Freed-Wu/digital-clock-report/README.md

digital-clock-report
====================

A backup of my homework.

Dependent
---------

1.  A LaTex distribution. Such as [texlive].

Install
-------

``` {.zsh}
git clone git@github.com:Freed-Wu/digital-clock-report
cd digital-clock-report
latexmk -pvc main.tex
```

Q & A
-----

More question see [Issues].

If you don't wanna compile, you can download the complied paper from
[Release]

  [texlive]: https://github.com/TeX-Live/texlive-source
  [Issues]: https://github.com/Freed-Wu/digital-clock-report/issues
  [Release]: https://github.com/Freed-Wu/digital-clock-report/releases/
