Freed-Wu/digital-clock-report/src/clock.tex

\RequirePackage[l2tabu, orthodox]{nag}
\RequirePackage{ifxetex}
\RequireXeTeX

\documentclass[tikz]{standalone}

%颜色
\usepackage{xcolor}

%长度
\usepackage{printlen}
\uselengthunit{mm}

%图形
\usepackage{pifont}
\usepackage{ean13isbn}
\usepackage{qrcode}
\usepackage{pdfpages}
\usepackage{overpic}
\usepackage{graphicx}

\usepackage{pstricks}

\usepackage{pgfplots}
\pgfplotsset{compat=1.16}
\usepackage{pgfmath}
\usepackage{pgf-pie}
\usetikzlibrary{calc}
\usetikzlibrary{shapes.geometric}
\usetikzlibrary{patterns}
\usetikzlibrary{arrows}
\usetikzlibrary{shapes}
\usetikzlibrary{chains}
\usetikzlibrary{mindmap}
\usetikzlibrary{graphs}
\usetikzlibrary{decorations.text}
\usetikzlibrary{arrows.meta}
\usetikzlibrary{shadows.blur}
\usetikzlibrary{shadings}

\usepackage{scsnowman}
\usepackage{circuitikz}
\usepackage{tikzpeople}
\usepackage{tikzducks}
\usepackage{flowchart}
\usepackage{smartdiagram}
\usepackage[edges]{forest}

%公式
\usepackage{amsmath}
\usepackage{amsthm}
\usepackage{amsfonts}
\usepackage{amssymb}
\usepackage{amsbsy}
\usepackage{amsopn}
\usepackage{amstext}
\usepackage{mathrsfs}
\usepackage{bm}
\usepackage{textcomp}
\usepackage{latexsym}
\usepackage{exscale}
\usepackage{relsize}
%\usepackage{xymtex}
\usepackage{physics}
\usepackage{siunitx}
\usepackage{hologo}
\usepackage{cases}

%文字
\usepackage{csquotes}
\usepackage{microtype}
\usepackage{ctex}

\csname
endofdump
\endcsname

\begin{document}

\begin{tikzpicture}[scale=1, transform shape]
	\tikzset{node distance=1.5cm}
	\node[anchor=south west,inner sep=0] (image) at (0,0) {};
	\begin{scope}[x={(image.south east)},y={(image.north west)}]

		%\draw[help lines,xstep=.1,ystep=.1] (0,0) grid (1,1);
		%\foreach \x in {0,1,...,9} {
		%\node [anchor=north] at (\x/10,0) {0.\x};
		%}
		%\foreach \y in {0,1,...,9} {
		%\node [anchor=east] at (0,\y/10) {0.\y};
		%}

		\draw[red, rounded corners] (0.05,0.85) rectangle (0.12,0.95);
		\node(电源总开关) at (0.09,0.95) [red, align=center, anchor=south] {\tiny 电源总开关};
		\draw[red, rounded corners] (.2,.75) rectangle (.55,.95);
		\node(动态译码) at (.35,.95) [red, align=center, anchor=south] {\tiny 动态译码};
		\draw[red, rounded corners] (.56,.82) rectangle (.8,.95);
		\node(显示) at (.65,.95) [red, align=center, anchor=south] {\tiny 显示};
		\draw[red, rounded corners] (.6,.62) rectangle (.83,.75);
		\node(亮度调节) at (.73,.75) [red, align=center, anchor=south] {\tiny 亮度调节};
		\draw[red, rounded corners] (.1,.45) rectangle (.44,.6);
		\node(计数) at (.35,.6) [red, align=center, anchor=south] {\tiny 计数};
		\draw[red, rounded corners] (.46,.45) rectangle (.85,.6);
		\node(动态选通) at (.55,.6) [red, align=center, anchor=south] {\tiny 动态选通};
		\draw[red, rounded corners] (.1,.1) rectangle (.25,.25);
		\node(校分) at (.13,.25) [red, align=center, anchor=south] {\tiny 校分};
		\draw[red, rounded corners] (.15,.28) rectangle (.25,.35);
		\node(信号指示) at (.2,.35) [red, align=center, anchor=south] {\tiny 信号指示};
		\draw[red, rounded corners] (.27,.1) rectangle (.5,.4);
		\node(脉冲发生) at (.4,.4) [red, align=center, anchor=south] {\tiny 脉冲发生};
		\draw[red, rounded corners] (.55,.1) rectangle (.77,.25);
		\node(报时) at (.65,.25) [red, align=center, anchor=south] {\tiny 报时};
		\draw[red, rounded corners] (.78,.1) rectangle (.85,.25);
		\node(清零) at (.81,.25) [red, align=center, anchor=south] {\tiny 清零};
	\end{scope}
\end{tikzpicture}

\end{document}
