Freed-Wu/digital-clock-report/(list of files, drawings)

Other design files:
src/clock0.ms14
